BadUwe/Pager/Bilder/PagerNr3.jpg

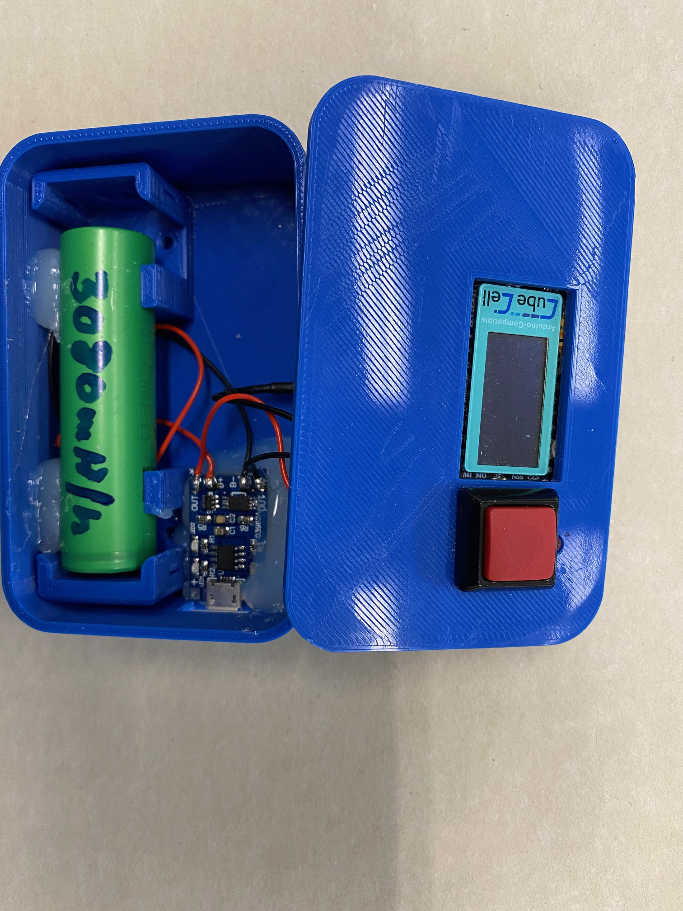
Bilder/PagerNr3.jpg
