BadUwe/Pager/Bilder/PagerNr2.jpg

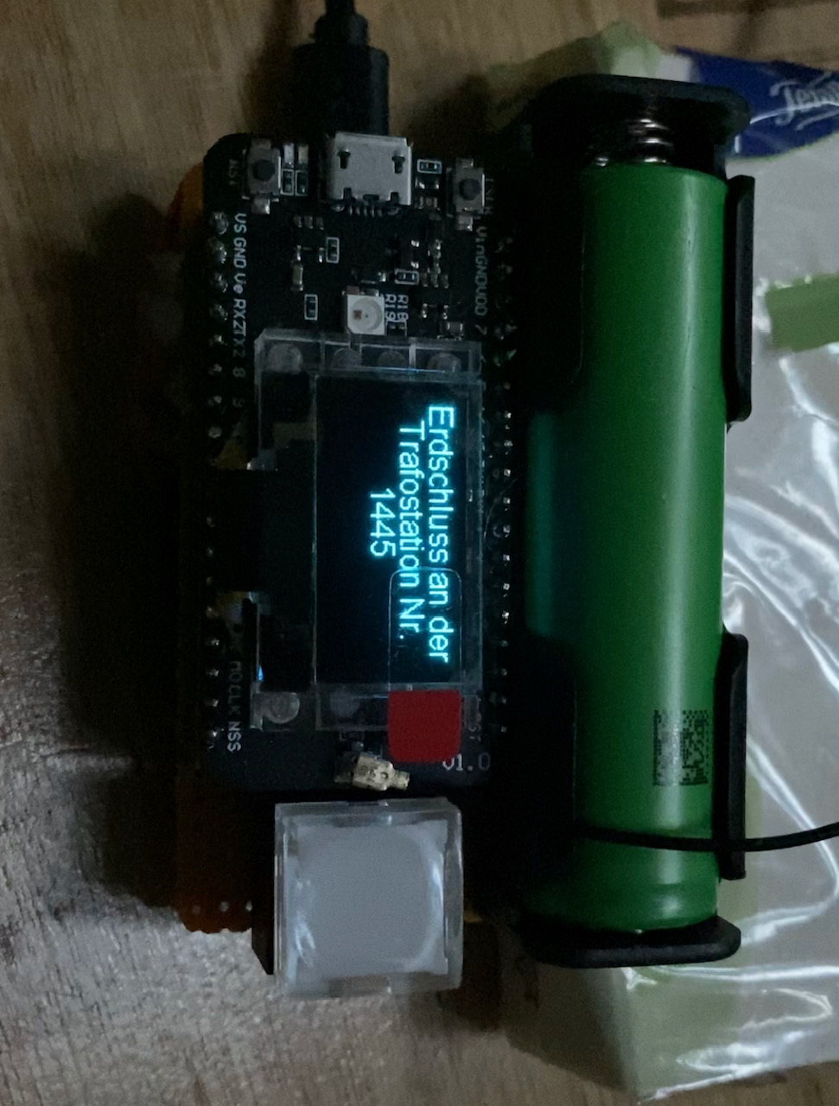
Bilder/PagerNr2.jpg
