BadUwe/Pager/README.md

# Praesentation-Pager
PDF der Pagerpraesentation

Licence Attribution-NonCommercial-ShareAlike 4.0 International [https://creativecommons.org/licenses/by-nc-sa/4.0/legalcode]
