BadUwe/Pager/Bilder/README.md

# STL Dateien zu den Bildern

[BildNr3](https://github.com/BadUwe/Pager/blob/main/3D%20Druck/Pager%20Deckel.stl) und [das](https://github.com/BadUwe/Pager/blob/main/3D%20Druck/Pager%20Geh%C3%A4use.stl)

[BildNr4](https://github.com/BadUwe/Pager/blob/main/3D%20Druck/Pager%20Komplett.stl)
