BadUwe/Pager/Bilder/PagerNr4.jpg

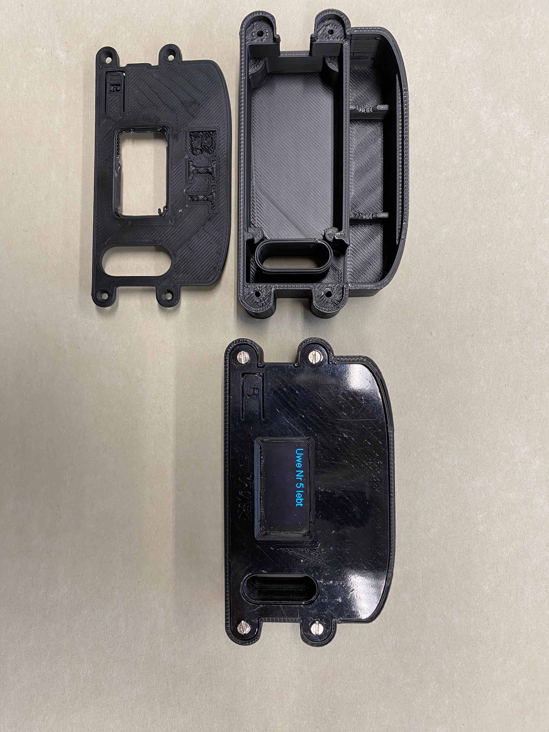
Bilder/PagerNr4.jpg
