BadUwe/Pager/3D Druck/Pager Komplett.stl

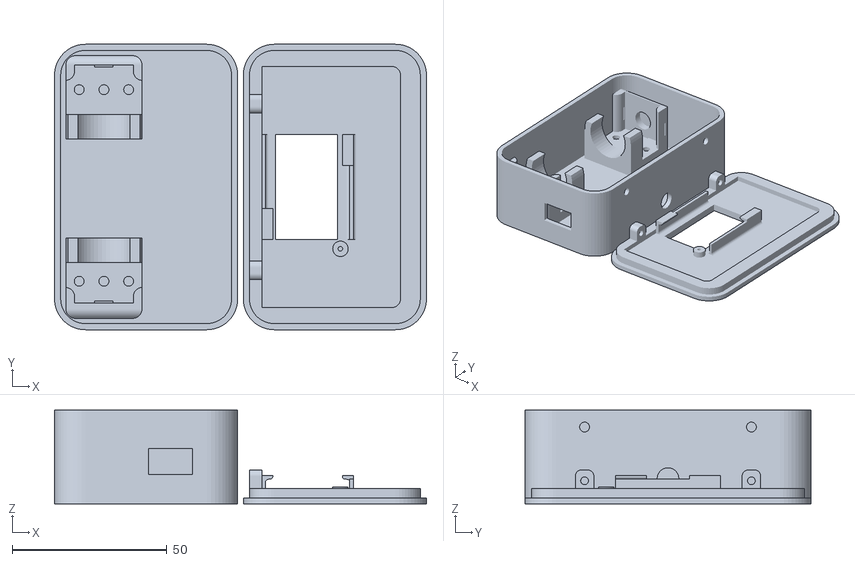
[picture p29: CAD file, 2021-06-07]
3D Druck/Pager Komplett.stl
120.4 x 92.4 x 30.4
