BadUwe/Pager/3D Druck/Pager Deckel.stl

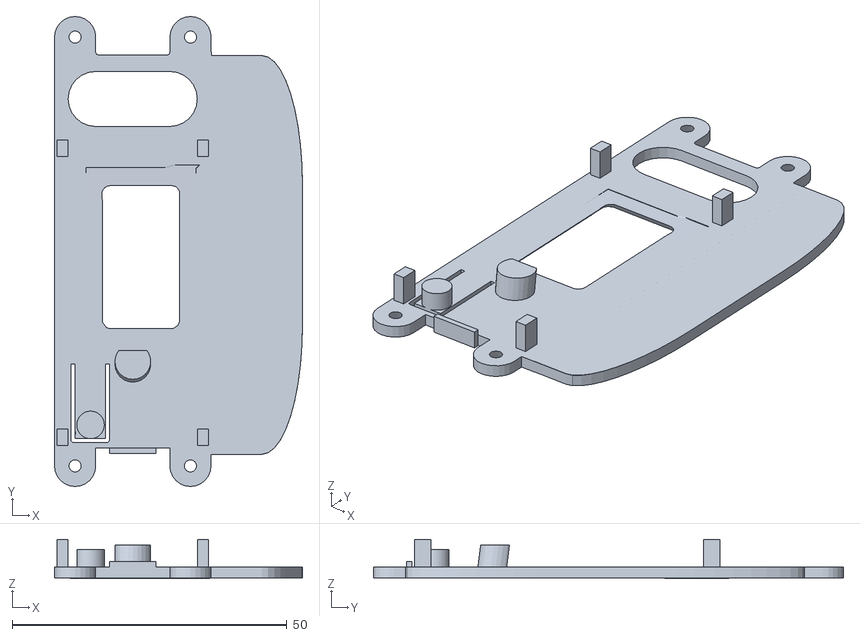
[picture p30: CAD file, 2021-06-07]
3D Druck/Pager Deckel.stl
45.1 x 85.5 x 7.10
