BadUwe/Pager/3D Druck/Pager Gehäuse.stl

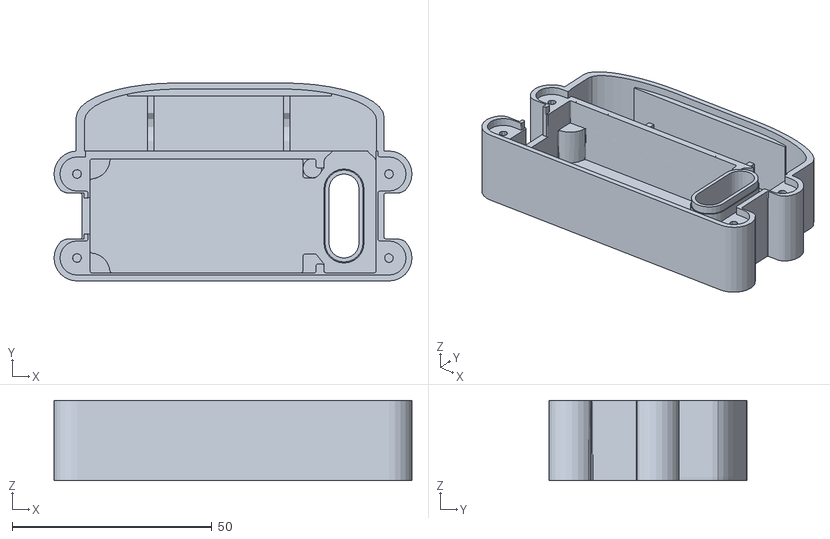
[picture p31: CAD file, 2021-06-07]
3D Druck/Pager Gehäuse.stl
89.5 x 49.5 x 20.0
